matejzm2019/SOC/docs/assets/model_soc.png

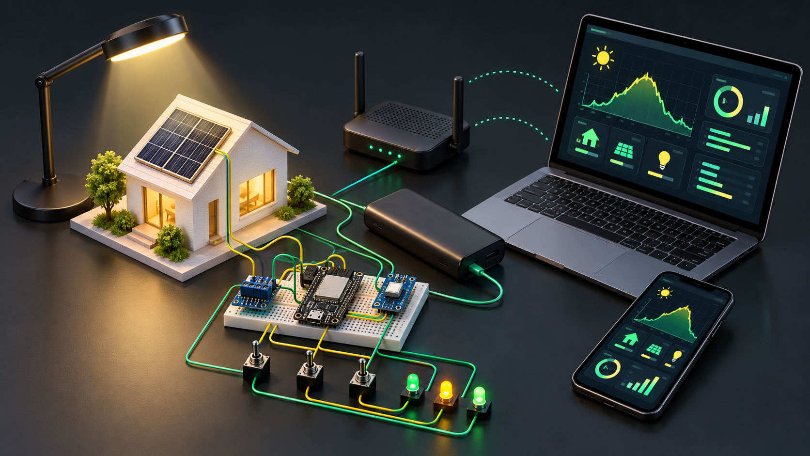
docs/assets/model_soc.png
