matejzm2019/SOC/model-domu/nahlady/dom-zatvoreny.jpg

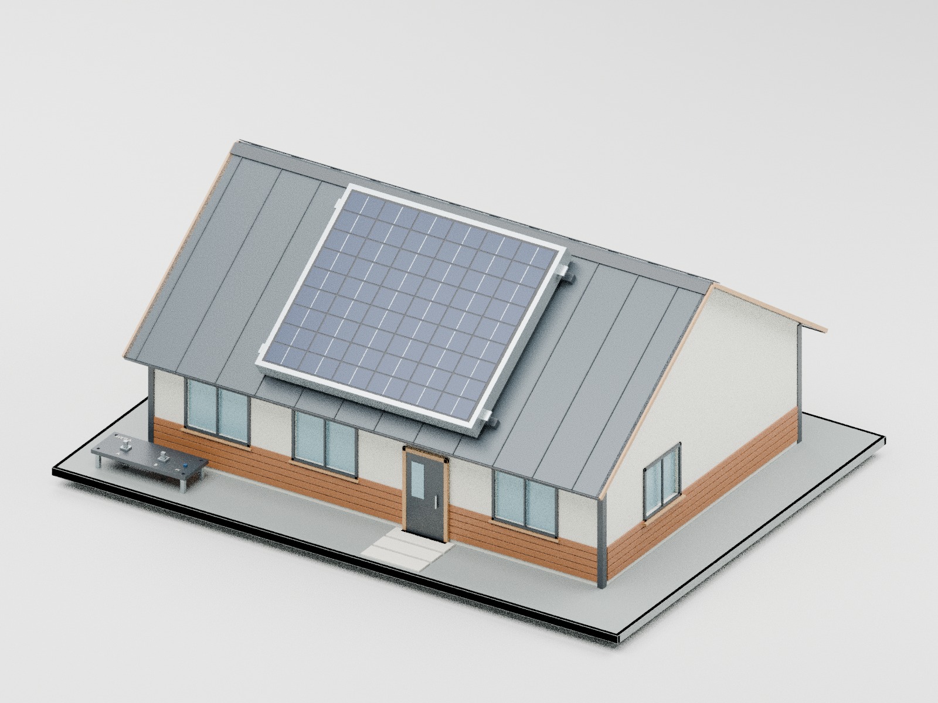
model-domu/nahlady/dom-zatvoreny.jpg
