matejzm2019/SOC/docs/KOMPONENTY.md

# Jednotný kusovník – menšia zostava

Platný návrh 10. 11. 2026. CN3791, MT3608, INA219 a relé boli overené na Techfun 10. 11. 2026; ceny bez dopravy. Ostatné drobnosti majú staršie orientačné ceny. Sklad sa priebežne mení. Vybraný je CN3791 + MT3608. Nekombinovať náhodne so starším návrhom BQ24074/MAX17048 alebo Waveshare Power Manager.

| ID | Ks | Diel | Cena spolu | Umiestnenie / poznámka |
|---|---:|---|---:|---|
| E01 | 1 | ESP32, 38-pinová USB-C doska označená ESP-32D | už máš | použiť dosku z fotografie; nejde o S3 N16R8 |
| E02 | 1 | [Chránená LiPo 104050 – 2500 mAh](https://techfun.sk/produkt/li-pol-bateria-kablik-ochranny-obvod/) | 5,80 € podľa fotografie | 3,7 V / 4,2 V, 50×40×10 mm, PH2.0; už vybraná |
| E03 | 1 | [CN3791, variant 12 V](https://techfun.sk/produkt/solarna-nabijacka-cn3791-pre-litiove-baterie/) | 4,40 € | 1S LiPo 3,7/4,2 V; pri kontrole 12 V variant skladom 2 ks; overiť MPPT bod a nabíjací prúd |
| E04 | 1 | [MT3608 bez USB](https://techfun.sk/produkt/step-up-menic-mt3608/) | 0,85–0,95 € | nastaviť 5,00 V; údaj 2 A nie je zaručený výstup pri všetkých podmienkach |
| E05 | 1 | Existujúci solárny panel označený 12 V | už máš / nový neobjednávať | výkon, Voc, rozmery a konektor neznáme; pred zapojením zmerať podľa ZAPOJENIE.md |
| E06/E07 | 2 | [INA219](https://techfun.sk/produkt/snimac-prudu-ina219-obojsmerny/) | 9,00 € | panel 0x40, batéria 0x41, logika 3,3 V; meraná vetva musí zostať s rezervou pod 26 V |
| E08 | 1 | [REL300 relé 5 V s optočlenom](https://techfun.sk/produkt/rele-modul-1-kanal-5v-so-zabudovanym-optoclenom/) | 1,40 € | spínanie LOW, NO/NC prepínajú LED |
| E09/E10 | 2 | BC547BBK, NPN 45 V / 100 mA / 500 mW | zo zásob | dve vetvy po 3 malých LED, cca 15–20 mA/vetva; overiť C/B/E |
| L01–L06 | 6 + 4 rezerva | [Biele LED 3 mm](https://techfun.sk/produkt/led-ka-1-kus-3mm-rozne-farby/) | 0,30 € za 10 | po tri na každý svetelný okruh |
| L07 | 1 + 1 rezerva | Modrá LED z rovnakej ponuky | 0,06 € za 2 | stav hlavného zdroja |
| S01/S02 | 2 | [SMTS-102](https://techfun.sk/produkt/kovovy-dvojpolohovy-prepinac-smts-102/) | 0,80 € | prepínače svetiel, logické kontakty proti GND |
| R | 4 balenia | [Rezistory ¼ W](https://techfun.sk/produkt/rezistor-rozne-hodnoty-1-4w-10-kusov/): 330 Ω, 1 kΩ, 10 kΩ, 22 kΩ | 1,00 € | 10 ks každej hodnoty; rezerva zostane |
| C | 1 + voliteľná rezerva | 470 µF / 16 V | zo zásob | pri ESP na 5 V, dodržať polaritu; 25 V netreba kupovať |
| J | 1 | [PH2.0 2-pin protikus/káblik](https://techfun.sk/produkt/ph2-0-kablik-samecsamica-2p/) | 0,40 € | naposledy vypredaný; XH2.54 ani JST1.25 nesedia |
| K | 2 balenia | [Dupont 20 cm](https://techfun.sk/produkt/kabliky-40-kusov-20-cm/), M–F a F–F | 4,40 € | na signály, nie motorové/hlavné napájanie |

## Ďalšie montážne diely

- Jedna univerzálna spájkovacia doska približne 50×30 mm (vyrezať z väčšej univerzálky), pinové lišty 2,54 mm a malé skrutkové svorky. Na doske z fotografie sú už lišty osadené.
- Dátový USB-C kábel na programovanie ESP; samostatný napájací USB-C kábel/prepojka od overených 5 V meniča. Neprepájať dve USB napájania bez overenia dosky.
- Rozpojiteľný dvojpinový konektor panela a skrutkové svorky; konkrétny protikus vybrať podľa skutočného konektora. Rozmer 3,5×1,35 mm už nie je potvrdený.
- Izolované vodiče približne 5 m červených a 5 m čiernych 0,25–0,5 mm², približne 15 m farebných 0,14–0,25 mm². Predstrihy sú v `model-domu/dlzky-vodicov.csv`; používaj z existujúcich zásob, netreba kupovať každú farbu zvlášť.
- Servisná rozpojiteľná dvojpinová prepojka medzi batériovým uzlom a MT3608, aby bolo možné pri úplnom prednabití odpojiť všetky záťaže.
- Izolačné stĺpiky pod PCB 4 mm, skrutky, sťahovacie pásky, príchytky vodičov, zmršťovacia bužírka. Batériu upevni mäkkým pásikom; nezovri ani neprepichni obal.
- Štyri 15 mm M3 stĺpiky pre panel C01, skrutky a matice; zápustné hlavy zospodu podstavy. Doska C01 100 × 40 × 4 mm; šablóna otvorov a popisy A/B/5V sú v modeli. Over závity reálnych prepínačov.
- Štyri nožičky pod dom, výška 10 mm, aby sa nestrihali vodiče pod podstavou.
- Úchyty podľa konštrukcie skutočného 12 V panela; štyri príchytky a lišty L04 v modeli sú predbežné. Dve výstuhy L03 zostávajú súčasťou strechy. Pôvodný rozpojiteľný konektor panela a odľahčenie ťahu; vodiče W18 po 650 mm vrátane pôvodného kábla. Konkrétny úchyt vyber podľa skutočného rámu, články nevŕtaj.
- Na fasádu balsa/cédrové lišty, rámy, parapety a voliteľný difúzny akrylát/papier. Kusy a dĺžky sú v model-domu/detaily-fasady.csv.
- Materiál domu: preglejka 8, 6 a 4 mm, lišta 10×10, lepidlo na drevo, brúsny papier, difúzny papier za okná a páska/tenká krycia lišta na spoj strechy. Presné diely Pxx/Lxx sú v rezacom pláne.
- Existujúci laboratórny zdroj, multimeter, spájkovačka, píla a vrtáky. Notebook a router nemusíš kupovať, ak ich už máš.

Štyri hlavné nákupné položky (CN3791 12 V, MT3608, 2× INA219 a 5 V relé) vychádzajú na **15,65–15,75 €** bez dopravy. Panel sa nekupuje znova. Drobnosti a prípadne batériu pripočítaj iba ak ich ešte nemáš; orientačná cena batérie z fotografie je 5,80 €, nie dnešná overená ponuka. Podrobný aktuálny zoznam: [PANEL-12V-A-OBJEDNAVKA.md](PANEL-12V-A-OBJEDNAVKA.md).

## Otvorené parametre pred dokončením zapojenia

1. Predajca pri článku nezverejňuje dovolený nabíjací prúd. Potvrď jeho hodnotu a zmeraj/nastav limit konkrétneho CN3791. Čip má maximum 4 A, ale to neurčuje ani skutočné nastavenie dosky, ani povolený prúd batérie.
2. Ak sa limit CN3791 musí meniť, používa sa merací rezistor: podľa datasheetu I = 0,120 V / RCS. Pre príklad 0,5 A je RCS = 0,24 Ω. Presné puzdro prenes z dosky; vhodný rezistor nebol v ponuke Techfun overený. Bežné rezistory 330 Ω/1 kΩ túto úpravu nenahrádzajú. Toto je reálna chýbajúca položka, ak má dodaná doska nevhodný limit; nedá sa poctivo predpokladať hotové zapojenie bez kontroly.
3. Potvrď rozmery a konektory fyzických modulov. Na ich montáž sú v 3D modeli rezervované obálky, nie garantované presné vrtné šablóny.

4. Z údaja 12 V nemožno odvodiť Voc ani výkon. INA219 má limit 26 V, CN3791 čip 28 V; platí aj nižší limit konkrétnej dosky/kondenzátorov. Pri meraní panela sa zachová rezerva; 32 V rozsah v registri INA219 nezvyšuje jeho 26 V elektrický limit.
