matejzm2019/SOC/model-domu/STAVEBNY-NAVOD.pdf

# Drevený smart dom – stavebný návod

Celé steny · celá strecha sa zdvihne · bez nábytku · panel priamo na streche


Podstava domu 600 × 450 × 8. Dom 480 × 330. Steny 120 vysoké, hrúbka 6. Priečky vysoké 100.

Strecha: sklon 35°, dve roviny 504 × 230 × 4; štíty a dorazy sú súčasťou jedného odnímateľného kusu.

12 V panel je na streche. Obrys 230 × 195 × 17 je predbežný; skutočný kus treba premerať.

Panel upevni za kovový rám na lišty L04. Elektronické otvory prenes zo skutočných dosiek.

SVG v priečinku vykresy sú 1:1; tento PDF prehľad nie je šablóna 1:1. Pred rezaním zmeraj hrúbku dosiek.

SOČ · verzia 2026-11-08 · všetky rozmery v mm · strana 1

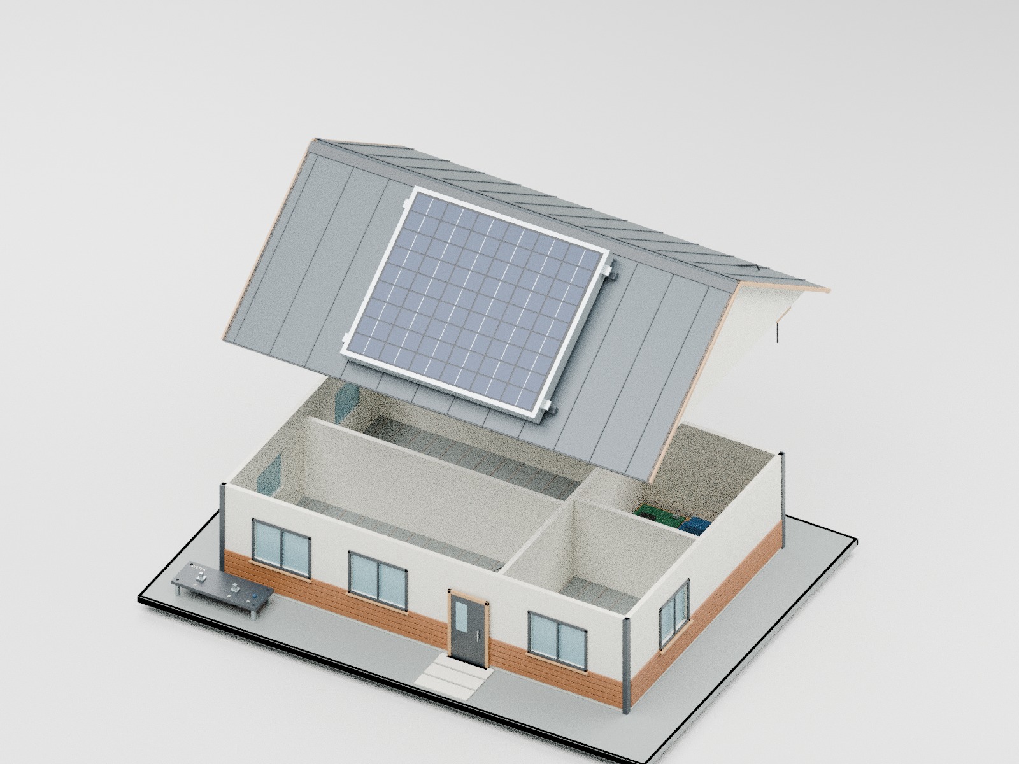
[picture p6: figure]

# Pôdorys a osadenie

Súradnice X/Y od ľavého predného rohu podstavy. Prepínače A/B sú na ľavom okraji podstavy, mimo chodníka.

ESP | CN3791
LiPo | MT3608 | INA40 INA41

RELÉ LED/ADC

ESP: X=385, Y=265; rezerva 64 × 28

CN3791: X=460, Y=265; rezerva 46 × 24

LiPo: X=385, Y=305; rezerva 50 × 40

MT3608: X=445, Y=305; rezerva 38 × 20

INA40: X=491, Y=303; rezerva 32 × 25

INA41: X=491, Y=335; rezerva 32 × 25

RELÉ: X=437, Y=349; rezerva 52 × 27

LED/ADC: X=385, Y=351; rezerva 50 × 30

Dom: X60–540, Y70–400.

Pozdĺžna priečka: X370–376.

Ľavá priečka: Y235–241.

Pravá priečka: Y250–256.

Doska elektroniky: X380 Y257.

Pod PCB 4 mm izolačné stĺpiky. Ovládanie: X30 Y18.

# Rezací plán

Čisté rozmery hotových dielov. Pripočítaj šírku rezu píly pri rozložení na materiál, nie k hotovému dielu.

ID | diel | ks | dĺžka | šírka | hrúbka
P01 | Podstava domu | 1 | 600 | 450 | 8
P02 | Predná stena | 1 | 480 | 120 | 6
P03 | Zadná stena | 1 | 480 | 120 | 6
P04 | Ľavá stena | 1 | 318 | 120 | 6
P05 | Pravá stena | 1 | 318 | 120 | 6
P06 | Pozdĺžna priečka | 1 | 318 | 100 | 6
P07 | Ľavá priečna priečka | 1 | 304 | 100 | 6
P08 | Pravá priečna priečka | 1 | 158 | 100 | 6
P09 | Vyberateľná doska elektroniky | 1 | 150 | 132 | 4
P10 | Rovina strechy | 2 | 504 | 230 | 4
P11 | Štít strechy | 2 | 330 | 115.53 | 4
L01 | Nosník strechy | 2 | 316 | 10 | 10
L02 | Vodiaci doraz strechy | 4 | 30 | 10 | 6
L03 | Výstuha pod panelom | 2 | 440 | 10 | 10
L04 | Montážna lišta panela | 2 | 250 | 8 | 6
C01 | Ovládací panel | 1 | 100 | 40 | 4

P11: základňa 330, výška 115,53 (výroba 115,5), vrchol X165. L03 podopiera prednú strešnú rovinu.

L02 prilep na spodnú stranu L01 (Z112–118). L03 dĺžky 440 nechaj medzi bočnými nosníkmi.

Strechu zlep do jedného rámu. Spoj rovín hore prekry páskou/tenkou lištou; pred lepením nasucho odskúšaj.

Odnímateľná doska elektroniky 150 × 132: nelep priamo batériu ani spodné kontakty PCB na drevo.

# Dĺžky vodičov

Predstrihy s rezervou pre trasu po stenách/pod podstavou. Pri prvej montáži skráť až po overení.

W01 LAB +5 V → hlavný rozvod | 1 × 600 mm · 0,5 mm²
W02 LAB GND → spoločná zem | 1 × 600 mm · 0,5 mm²
W03 Batéria → INA219 0x41 | 2 × 150 mm · 0,25–0,5 mm²
W04 INA219 → batériový uzol | 1 × 120 mm · 0,25–0,5 mm²
W05 CN3791 BAT → batériový uzol | 2 × 150 mm · 0,25–0,5 mm²
W06 Batériový uzol → MT3608 cez servisnú prepojku | 2 × 150 mm · 0,25–0,5 mm²
W07 MT3608 5 V → relé NC | 1 × 150 mm · 0,25–0,5 mm²
W08 Hlavný +5 V → relé NO a VCC | 2 × 150 mm · 0,25–0,5 mm²
W09 Relé COM → LED vetva A | 2 × 750 mm · 0,14–0,25 mm²
W10 Relé COM → LED vetva B | 2 × 500 mm · 0,14–0,25 mm²
W11 Rozvod 3 LED A na stene | 2 × 300 mm · 0,14 mm²
W12 Rozvod 3 LED B na stene | 2 × 300 mm · 0,14 mm²
W13 Prepínač A → GPIO32/GND | 2 × 900 mm · 0,14 mm²
W14 Prepínač B → GPIO33/GND | 2 × 900 mm · 0,14 mm²
W15 MT3608 → ESP napájací USB-C kábel | 1 × 200 mm · hotový kábel
W16 I²C ESP → INA219 0x40 | 4 × 180 mm · 0,14 mm²
W17 I²C INA219 0x40 → 0x41 | 4 × 100 mm · 0,14 mm²
W18 Panel na streche → INA219 | 2 × 650 mm · 0,25–0,5 mm²
W19 Panelový INA219 → CN3791 IN | 2 × 150 mm · 0,25–0,5 mm²
W24 GPIO34 delič a tranzistory LED | 8 × 150 mm · 0,14 mm²
W25 LED hlavného zdroja → GPIO27/GND | 2 × 900 mm · 0,14 mm²

W18: 2 × 650 mm celkom vrátane pôvodného kábla panela; aspoň 200 mm servisná slučka.

Konektor panela označ SOLÁR a upevni proti ťahu. Pred úplným odložením strechy ho rozpoj.

Napájanie neveď cez tenké Dupont kontakty. Tie používaj na signály a krátke I²C prepoje.

# Zapojenie – rozhodujúce uzly

Úplná pinová tabuľka a poradie montáže sú v docs/ZAPOJENIE.md. Batéria sa nepripája priamo na panel ani LAB.

12 V panel → INA219 0x40 → CN3791 IN (12 V variant). Nabíja jediný chránený 1S článok na 4,2 V.

Pred zapojením zmeraj Voc: INA219 max. 26 V, CN3791 max. 28 V; zachovať rezervu a overiť modul.

CN3791 BAT+ a MT3608 IN+ tvoria batériový uzol → INA219 0x41 VIN+ → VIN− → plus batérie.

INA219 meria čistý prúd celého článku. Všetky odbery/nabíjanie musia byť na strane uzla, nie mimo bočníka.

MT3608 nastav na 5,00 V pred pripojením ESP32. Menovitý 2 A údaj nie je zaručený výstup pri 3,7 → 5 V.

Relé REL300: NO = hlavné +5 V; NC = MT3608 +5 V; COM = LED napájanie. VCC/JD-VCC = hlavné 5 V.

Relé IN je pevne na GND. Zapnutý hlavný zdroj pritiahne NO; po vypnutí kontakt prejde na NC.

LED A/B: každá LED cez svoj 330 Ω; kolektory BC547B, emitory GND; GPIO25/26 cez 1 kΩ na bázy.

Každá báza má 10 kΩ na GND. Prepínače svetiel: GPIO32/33 proti GND, druhý kontakt na prepínači voľný.

Detekcia hlavného zdroja: LAB +5 V → 22 kΩ → GPIO34 → 10 kΩ → GND. Pri 5 V je ADC asi 1,56 V.

I²C: GPIO21 SDA, GPIO22 SCL; oba INA219 napájané 3,3 V. Druhému nastav adresu 0x41.

470 µF / 16 V pri ESP: plus na BACKUP 5 V, mínus na GND. ESP32 je stále na MT3608. Pri slabom solári môže batéria klesať aj vtedy, keď hlavný zdroj napája LED.

CN3791 nemá hotový oddelený LOAD výstup. Na úplné prednabitie odpoj MT3608, svetlá aj ESP od článku.

Pri úplnom prednabití odpoj panel, napájaj iba CN3791 zo správne nastaveného LAB; potom obnov solár.

Nastavenie prúdu CN3791 over podľa článku. Hodnota 4 A MAX na e-shope nie je povolený prúd tejto batérie.

# Montáž a prvé spustenie

Postupuj po častiach; elektroniku najprv odskúšaj mimo dreveného domu.

1. Vyrež a označ P01–P11, nasucho zostav steny; zmeraj skutočnú hrúbku materiálu a šírku rezu.
2. Vyrež okná podľa SVG, obrús hrany. Steny lepia na podstavu; krátke bočné steny sú medzi čelnými.
3. Pridaj priečky a vyberateľnú dosku elektroniky; tá zostáva dostupná zhora po zdvihnutí strechy.
4. Zostav rám strechy a dve roviny do jedného kusu. Dorazy nechaj s vôľou; nepouži pánty; panel má vlastný rozpojiteľný kábel.
5. LED upevni na pevné steny. Každá má vlastný rezistor; horné káble prichyť, aby ich strecha nezachytila.
6. Pod podstavu nalep 10 mm nožičky. Signalizačné a napájacie trasy prichyť na spodnú stranu a označ Wxx.
7. Menič otestuj s malou skúšobnou záťažou; nastav a zmeraj 5 V. Over polaritu batérie a adresy INA219.
8. Zapoj relé a LED, potom ESP. Vyskúšaj výpadok aj pri odpojenej Wi-Fi; prepnutie nesmie vyžadovať server.
9. Upevni panel za rám; potom na PC spusti aplikáciu a Ollamu. ESP a PC pripoj do rovnakej Wi-Fi/LAN, nastav URL a kľúč zariadenia.

Bezpečné napätia sú iba DC vetvy modelu. Notebook a Wi-Fi router zostanú počas ukážky zapnuté.

Aktuálny kusovník: docs/KOMPONENTY.md; popis celého systému a AI: docs/AKO-TO-FUNGUJE.md.

Uchytenie prispôsob skutočnému panelu; rozmery a hmotnosť 12 V kusa nie sú potvrdené.

# Doplnkové detaily fasády a strechy

Všetko sú jednoduché nalepené lišty; žiadny nábytok ani otváracie dvere.

A01a Cédrový obklad čelný | 10 ks · 480 × 6 × 1.5 mm
A01b Cédrový obklad bočný | 10 ks · 318 × 6 × 1.5 mm
A02 Rohové lišty | 4 ks · 120 × 6 × 7 mm
A03v Zvislé rámy okien | 16 ks · 54 × 3 × 2 mm
A03h64 Vodorovné rámy predné | 6 ks · 70 × 3 × 2 mm
A03h56 Vodorovné rámy ostatné | 10 ks · 62 × 3 × 2 mm
A03m Stredové priečniky okien | 8 ks · 48 × 2 × 2 mm
A04a Parapety predné | 3 ks · 74 × 7 × 2 mm
A04b Parapety ostatné | 5 ks · 66 × 7 × 2 mm
A05a Pevná doska dverí | 1 ks · 82 × 40 × 2 mm
A05b Zárubne dverí | 2 ks · 86 × 4 × 3 mm
A05c Nadpražie dverí | 1 ks · 48 × 4 × 3 mm
A05d Prah dverí | 1 ks · 48 × 10 × 2 mm
A06 Naznačené strešné falce | 24 ks · 230 × 1 × 1 mm
A07 Dvojdielny hrebenáč | 2 ks · 504 × 12 × 1 mm
A08 Odkvapové lišty | 2 ks · 504 × 6 × 4 mm
A09 Štítové lišty | 4 ks · 230 × 6 × 4 mm
A10 Vstupné nášľapy | 3 ks · 62 × 18 × 2 mm

Tieto detaily sú v detaily-fasady.csv. Falcovanie môžeš nahradiť nakreslenými čiarami na streche.
