matejzm2019/SOC/model-domu/nahlady/dom-podorys-3d.jpg

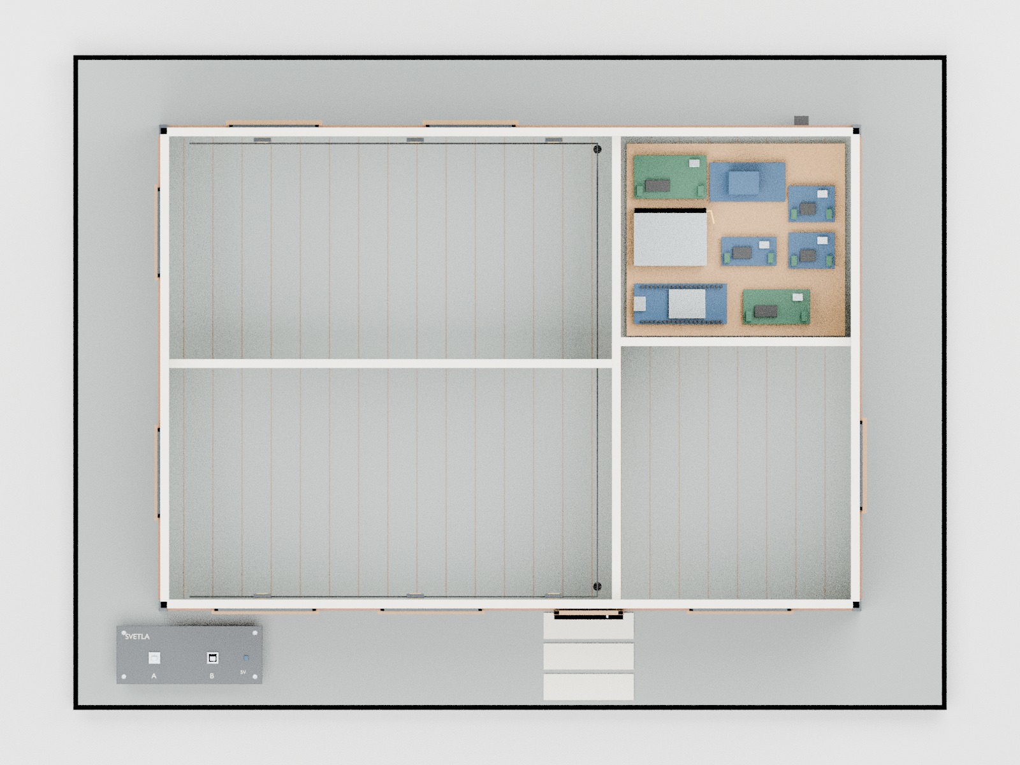
model-domu/nahlady/dom-podorys-3d.jpg
