matejzm2019/SOC/model-domu/rezaci-plan.csv

ID | diel | kusy | dlzka_mm | sirka_mm | hrubka_mm | material | poznamka
P01 | Podstava domu | 1 | 600 | 450 | 8 | preglejka | 4 nožičky 10 mm; otvory káblov podľa pôdorysu
P02 | Predná stena | 1 | 480 | 120 | 6 | preglejka | 3 okná 64x48; pevné nalepené dvere
P03 | Zadná stena | 1 | 480 | 120 | 6 | preglejka | 2 okná 56x48; otvor Ø8 pri technickej miestnosti
P04 | Ľavá stena | 1 | 318 | 120 | 6 | preglejka | 2 okná 56x48
P05 | Pravá stena | 1 | 318 | 120 | 6 | preglejka | 1 okno 56x48
P06 | Pozdĺžna priečka | 1 | 318 | 100 | 6 | preglejka | výška 100; horných 20 mm necháva prístup
P07 | Ľavá priečna priečka | 1 | 304 | 100 | 6 | preglejka | kolmo medzi ľavú stenu a P06
P08 | Pravá priečna priečka | 1 | 158 | 100 | 6 | preglejka | oddeľuje technickú miestnosť
P09 | Vyberateľná doska elektroniky | 1 | 150 | 132 | 4 | preglejka | dosky uchytiť na dištančné stĺpiky
P10 | Rovina strechy | 2 | 504 | 230 | 4 | preglejka | sklon 35°; obe roviny tvoria odnímateľnú strechu
P11 | Štít strechy | 2 | 330 | 115.53 | 4 | preglejka | trojuholník; pri výrobe výška 115,5 mm
L01 | Nosník strechy | 2 | 316 | 10 | 10 | lišta | spája štíty a tvorí jeden kus strechy
L02 | Vodiaci doraz strechy | 4 | 30 | 10 | 6 | lišta | vôľa aspoň 0,5–1 mm
L03 | Výstuha pod panelom | 2 | 440 | 10 | 10 | lišta | pozdĺž strechy, pod prednou rovinou
L04 | Montážna lišta panela | 2 | 250 | 8 | 6 | lišta | predbežná dĺžka podľa obálky; upraviť podľa skutočného 12 V panela
C01 | Ovládací panel | 1 | 100 | 40 | 4 | preglejka | X30 Y18 na 15 mm stĺpikoch; A/B Ø6; LED Ø3; závit over na skutočnom prepínači
