matejzm2019/SOC/model-domu/3d/dom-mm.stl

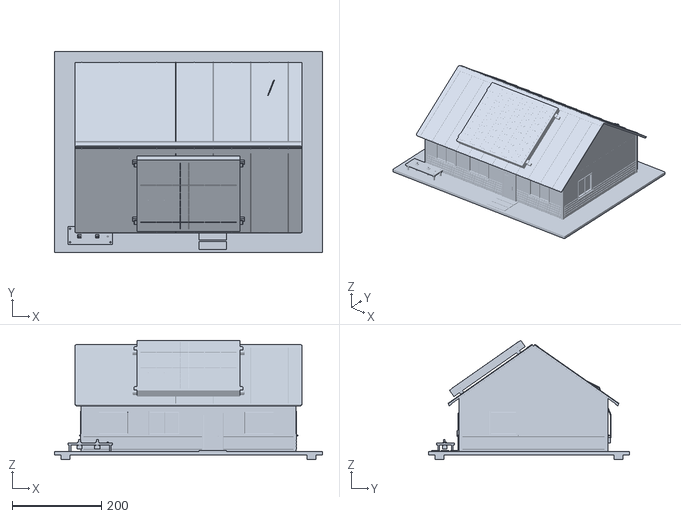
[picture p8: CAD file, 2026-11-08]
model-domu/3d/dom-mm.stl
600.0 x 450.0 x 266.7
