matejzm2019/SOC/(list of files, cad)

Other CAD files:
model-domu/3d/dom.blend
