matejzm2019/SOC/(commit log)

2026-10-02 fix: separate software demo from ESP32 house mode
2026-10-02 feat: add spot prices and solar cell monitoring, fix chat filtering
    [energia_esp32_s3.ino]
2026-10-02 fix: report current application version in health check
2026-11-10 Adapt house to photographed ESP-32D board, BC547 and 470uF 16V capacitor
2026-11-10 Adapt solar input and shopping plan to existing 12V panel without guessing its specifications
2026-11-10 Use two INA3221 monitors and consolidate the complete component and material inventory
